chez-d/ruler-osh/README.md

# ruler-osh
OSH version of my personal PCB ruler

Use it for what you want, but it would be nice to credit me.
It's a 15cm ruler - but also a FPGA dev board, music player, game console, and component footprint reference...
Best on OSHPark After Dark.
