chez-d/ruler-osh/ruler.kicad_pcb

## KiCad design ruler.kicad_pcb (2025-02-06)

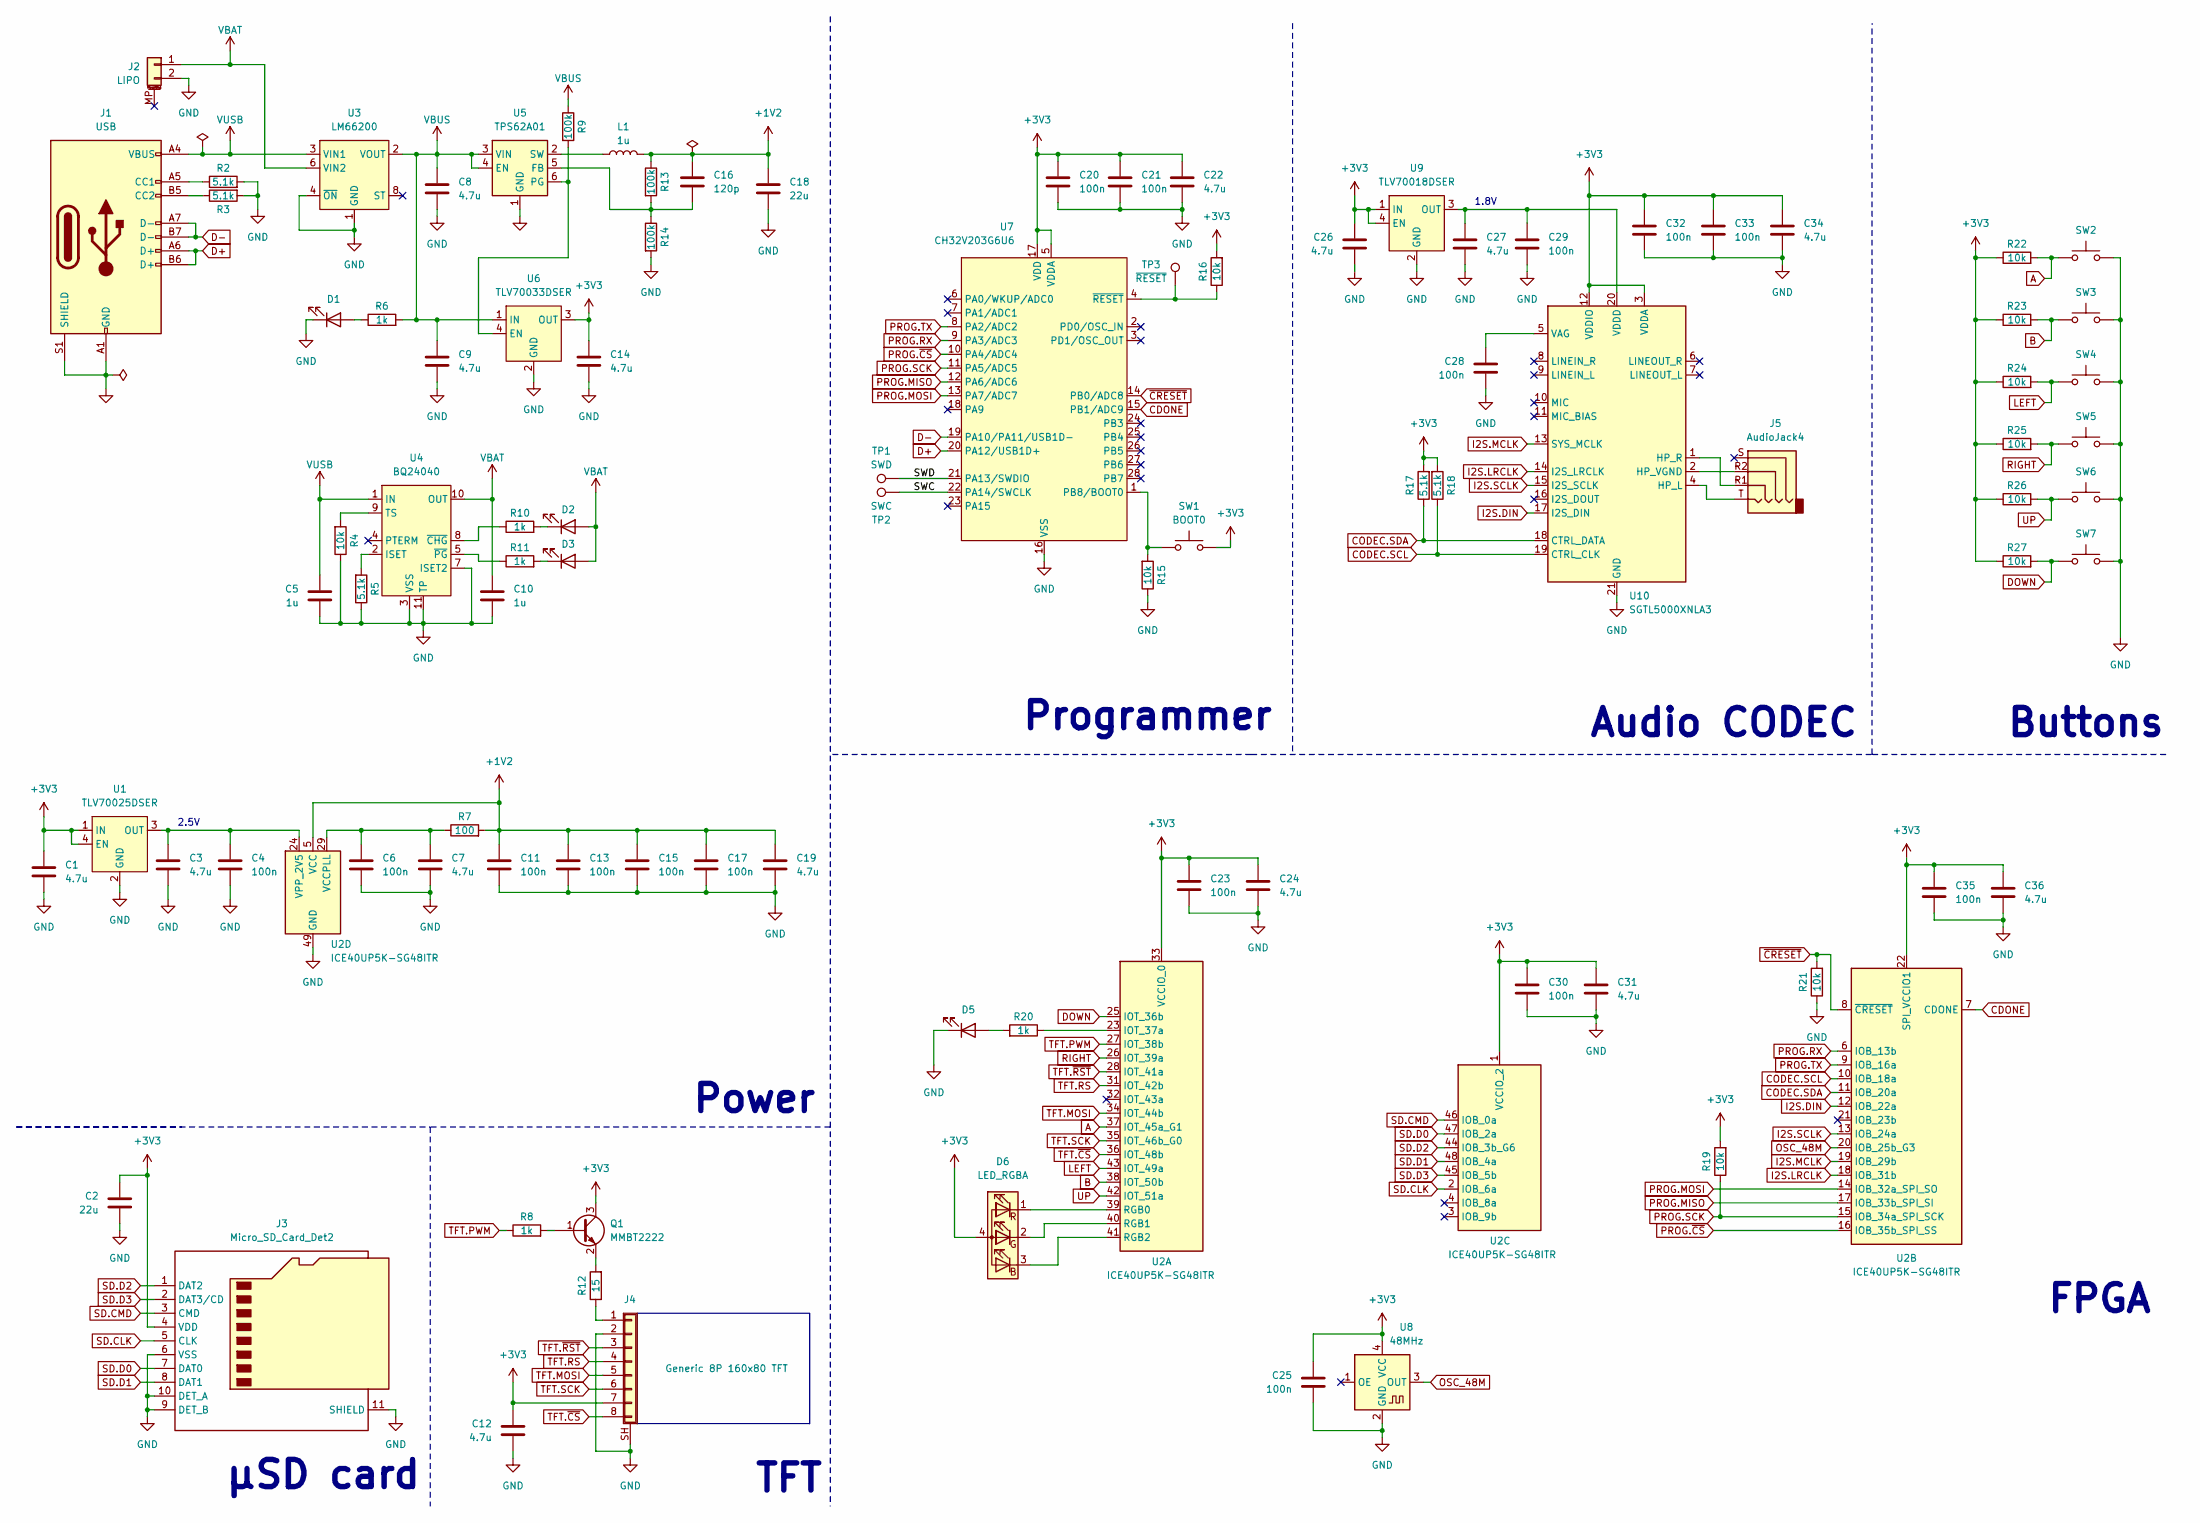
[picture p1: schematic ruler.kicad_sch]

Parts:
C1, C3, C7, C8, C9, C12, C14, C19, C22, C24, C26, C27, C31, C34, C36: 4.7u; C_0402_1005Metric
C2, C18: 22u; C_0805_2012Metric
C4, C6, C11, C13, C15, C17, C20, C21, C23, C25, C28, C29, C30, C32, C33, C35: 100n; C_0402_1005Metric
C5, C10: 1u; C_0402_1005Metric
C16: 120p; C_0402_1005Metric
D1, D5: LED; LED_0603_1608Metric
D2: ORANGE; LED_0603_1608Metric
D3: GREEN; LED_0603_1608Metric
D6: LED_RGBA; XL-B1515RGBA-HF
J1: USB; USB_C_Receptacle_HCTL_HC-TYPE-C-16P-01A
J2: LIPO; JST_PH_S2B-PH-SM4-TB_1x02-1MP_P2.00mm_Horizontal
J3: Micro_SD_Card_Det2; microSD_HC_Molex_104031-0811
J4: Generic 8P 160x80 TFT; LCD_1x8_Newvision
J5: AudioJack4; Jack_3.5mm_PJ320D_Horizontal
L1: 1u; L_Murata_DFE201610P
Q1: MMBT2222; SOT-723
R2, R3, R5, R17, R18: 5.1k; R_0402_1005Metric
R4, R15, R16, R19, R21, R22, R23, R24, R25, R26, R27: 10k; R_0402_1005Metric
R6, R8, R10, R11, R20: 1k; R_0402_1005Metric
R7: 100; R_0402_1005Metric
R9, R13, R14: 100k; R_0402_1005Metric
R12: 15; R_0402_1005Metric
SW1: BOOT0; SW_SPST_PTS815
SW2, SW3, SW4, SW5, SW6, SW7: SW_Push; SW_SPST_PTS815
TP1: SWD; TestPoint
TP2: SWC; TestPoint
TP3: ~{RESET}; TestPoint
U1: TLV70025DSER; WSON-6_1.5x1.5mm_P0.5mm
U2: ICE40UP5K-SG48ITR; QFN-48-1EP_7x7mm_P0.5mm_EP5.6x5.6mm
U3: LM66200; SOT-583-8
U4: BQ24040; WSON-10_EP_2x2_Pitch0.4mm
U5: TPS62A01; SOT-563
U6: TLV70033DSER; WSON-6_1.5x1.5mm_P0.5mm
U7: CH32V203G6U6; QFN-28-1EP_4x4mm_P0.4mm_EP2.8x2.8mm
U8: 48MHz; Crystal_SMD_2016-4Pin_2.0x1.6mm
U9: TLV70018DSER; WSON-6_1.5x1.5mm_P0.5mm
U10: SGTL5000XNLA3; QFN-20-1EP_3x3mm_P0.4mm_EP1.65x1.65mm

Connections:
+1V2: C11.1, C13.1, C15.1, C16.1, C17.1, C18.1, C19.1, L1.2, R7.2, R13.1, U2.5 (VCC), U2.30 (VCC)
+3V3: C1.1, C2.1, C12.1, C14.1, C20.1, C21.1, C22.1, C23.1, C24.1, C25.1, C26.1, C30.1, C31.1, C32.1, C33.1, C34.1, C35.1, C36.1, D6.4 (A), J3.4 (VDD), J4.7, Q1.3 (C), R16.2, R17.2, R18.2, R19.2, R22.1, R23.1, R24.1, R25.1, R26.1, R27.1, SW1.2, U1.1 (IN), U1.4 (EN), U2.1 (VCCIO_2), U2.22 (SPI_VCCIO1), U2.33 (VCCIO_0), U6.3 (OUT), U7.5 (VDDA), U7.17 (VDD), U8.4 (VCC), U9.1 (IN), U9.4 (EN), U10.3 (VDDA), U10.12 (VDDIO)
/SWC: TP2.1, U7.22 (PA14/SWCLK)
/SWD: TP1.1, U7.21 (PA13/SWDIO)
A: R22.2, SW2.1, U2.37 (IOT_45a_G1)
B: R23.2, SW3.1, U2.38 (IOT_50b)
CDONE: U2.7 (CDONE), U7.15 (PB1/ADC9)
CODEC.SCL: R18.1, U2.10 (IOB_18a), U10.19 (CTRL_CLK)
CODEC.SDA: R17.1, U2.11 (IOB_20a), U10.18 (CTRL_DATA)
D+: J1.A6 (D+), J1.B6 (D+), U7.20 (PA12/USB1D+)
D-: J1.A7 (D-), J1.B7 (D-), U7.19 (PA10/PA11/USB1D-)
DOWN: R27.2, SW7.1, U2.25 (IOT_36b)
GND: C1.2, C2.2, C3.2, C4.2, C5.2, C6.2, C7.2, C8.2, C9.2, C10.2, C11.2, C12.2, C13.2, C14.2, C15.2, C17.2, C18.2, C19.2, C20.2, C21.2, C22.2, C23.2, C24.2, C25.2, C26.2, C27.2, C28.2, C29.2, C30.2, C31.2, C32.2, C33.2, C34.2, C35.2, C36.2, D1.1 (K), D5.1 (K), J1.A1 (GND), J1.A12 (GND), J1.B1 (GND), J1.B12 (GND), J1.S1 (SHIELD), J2.2, J3.6 (VSS), J3.9 (DET_B), J3.10 (DET_A), J3.11 (SHIELD), J4.2, J4.SH (Shield), R2.2, R3.2, R4.1, R5.1, R14.2, R15.1, R21.1, SW2.2, SW3.2, SW4.2, SW5.2, SW6.2, SW7.2, U1.2 (GND), U1.5 (NC), U1.6 (NC), U2.49 (GND), U3.1 (GND), U3.4 (~ON), U3.5 (GND), U4.3 (VSS), U4.7 (ISET2), U4.11 (TP), U5.1 (GND), U6.2 (GND), U6.5 (NC), U6.6 (NC), U7.16 (VSS), U7.29 (VSS), U8.2 (GND), U9.2 (GND), U9.5 (NC), U9.6 (NC), U10.21 (GND)
I2S.DIN: U2.12 (IOB_22a), U10.17 (I2S_DIN)
I2S.LRCLK: U2.18 (IOB_31b), U10.14 (I2S_LRCLK)
I2S.MCLK: U2.19 (IOB_29b), U10.13 (SYS_MCLK)
I2S.SCLK: U2.13 (IOB_24a), U10.15 (I2S_SCLK)
LEFT: R24.2, SW4.1, U2.43 (IOT_49a)
unnamed: D1.2 (A), R6.1
unnamed: D2.1 (K), R10.2
unnamed: D3.1 (K), R11.2
unnamed: D5.2 (A), R20.2
unnamed: D6.3 (BK), U2.41 (RGB2)
unnamed: D6.2 (GK), U2.40 (RGB1)
unnamed: D6.1 (RK), U2.39 (RGB0)
unnamed: J1.A5 (CC1), R2.1
unnamed: J1.B5 (CC2), R3.1
unnamed: J4.1, R12.1
unnamed: Q1.1 (B), R8.2
unnamed: Q1.2 (E), R12.2
unnamed: C3.1, C4.1, U1.3 (OUT), U2.24 (VPP_2V5)
unnamed: R20.1, U2.23 (IOT_37a)
unnamed: C6.1, C7.1, R7.1, U2.29 (VCCPLL)
unnamed: R5.2, U4.2 (ISET)
unnamed: R4.2, U4.9 (TS)
unnamed: R10.1, U4.8 (~CHG)
unnamed: R11.1, U4.5 (~PG)
unnamed: C16.2, R13.2, R14.1, U5.5 (FB)
unnamed: R9.2, U5.6 (PG), U6.4 (EN)
unnamed: L1.1, U5.2 (SW)
unnamed: R15.2, SW1.1, U7.1 (PB8/BOOT0)
unnamed: R16.1, TP3.1, U7.4 (~RESET)
unnamed: J5.T, U10.4 (HP_L)
unnamed: J5.R1, U10.1 (HP_R)
unnamed: J5.R2, U10.2 (HP_VGND)
unnamed: C28.1, U10.5 (VAG)
unnamed: C27.1, C29.1, U9.3 (OUT), U10.20 (VDDD)
OSC_48M: U2.20 (IOB_25b_G3), U8.3 (OUT)
PROG.MISO: U2.17 (IOB_33b_SPI_SI), U7.12 (PA6/ADC6)
PROG.MOSI: U2.14 (IOB_32a_SPI_SO), U7.13 (PA7/ADC7)
PROG.RX: U2.6 (IOB_13b), U7.9 (PA3/ADC3)
PROG.SCK: R19.1, U2.15 (IOB_34a_SPI_SCK), U7.11 (PA5/ADC5)
PROG.TX: U2.9 (IOB_16a), U7.8 (PA2/ADC2)
PROG.~CS: U2.16 (IOB_35b_SPI_SS), U7.10 (PA4/ADC4)
RIGHT: R25.2, SW5.1, U2.26 (IOT_39a)
SD.CLK: J3.5 (CLK), U2.2 (IOB_6a)
SD.CMD: J3.3 (CMD), U2.46 (IOB_0a)
SD.D0: J3.7 (DAT0), U2.47 (IOB_2a)
SD.D1: J3.8 (DAT1), U2.48 (IOB_4a)
SD.D2: J3.1 (DAT2), U2.44 (IOB_3b_G6)
SD.D3: J3.2 (DAT3/CD), U2.45 (IOB_5b)
TFT.MOSI: J4.5, U2.34 (IOT_44b)
TFT.PWM: R8.1, U2.27 (IOT_38b)
TFT.RS: J4.4, U2.31 (IOT_42b)
TFT.SCK: J4.6, U2.35 (IOT_46b_G0)
TFT.~CS: J4.8, U2.36 (IOT_48b)
TFT.~RST: J4.3, U2.28 (IOT_41a)
UP: R26.2, SW6.1, U2.42 (IOT_51a)
VBAT: C10.1, D2.2 (A), D3.2 (A), J2.1, U3.6 (VIN2), U4.10 (OUT)
VBUS: C8.1, C9.1, R6.2, R9.1, U3.2 (VOUT), U3.7 (VOUT), U5.3 (VIN), U5.4 (EN), U6.1 (IN)
VUSB: C5.1, J1.A4 (VBUS), J1.A9 (VBUS), J1.B4 (VBUS), J1.B9 (VBUS), U3.3 (VIN1), U4.1 (IN)
~CRESET: R21.2, U2.8 (~CRESET), U7.14 (PB0/ADC8)

Notes on the sheet:
Power
Buttons
1.8V
2.5V
Programmer
FPGA
TFT
µSD card
Audio CODEC

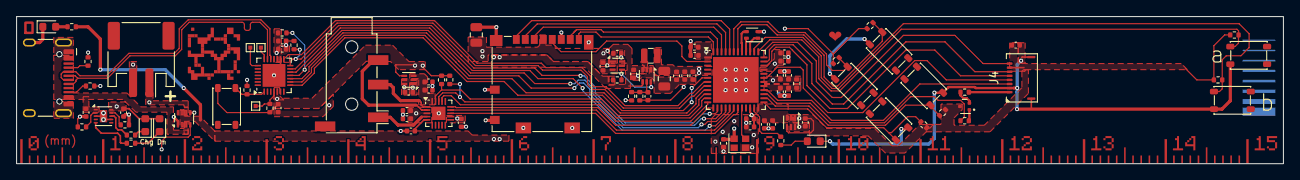
[picture p2: board ruler.kicad_pcb from above]

Board: 2 copper layers, 155.0 x 18.0 mm, 95 parts (0 on the bottom side), 72 nets.

Other parts of the board:
PCB1: Ruler
